NickLekas/436.5MHz-LNA/README.md

# 436.5MHz-LNA
A JFET common gate LNA for 436.5MHz

This is untested and may not work as designed.
