NickLekas/436.5MHz-LNA/LTSpice/LNA.asc

C1: cap; {Cdc}
C2: cap; {Cdc}
C3: cap; {Cdc}
C4: cap; {Cc}
C5: cap; {Cdc}
J1: njf; J310
L1: ind; {L1tune}
L2: ind; {L2tune}
L3: ind; {L3tune}
R1: res; {Rsource}
R2: res; {Rdrain}
R3: res; {Lloss}
R4: res; 100
R5: res; 50
R6: res; {Lloss}
R7: res; 50
R8: res; 10E6
R9: res; {Lloss}
V1: voltage; 9V
V2: voltage; ""; AC 2
V3: voltage; ""; AC 1
Named nets: 0, S11, S21
.param L2tune 39n
.param L3tune 39n
Output stage
.param Cc 1.2p
.param Lloss 2
.param Rsource 100
.ac lin 800 200Meg 800Meg
.model J310 NJF(Beta=3.384m Rd=1 Rs=1 Lambda=17m Vto=-3.409
+IS=193.9f Cgd=6.2p Pb=1 Fc=.5 Cgs=6.2p Kf=46.34E-18 Af=1)
.param L1tune 36n
input impedance ~180ohm
Use resonant inductor for L1 to tune S11
Input stage
Coupling L2 and L3 seems to make things worse
A coupling cap does improve performance, need to mess with coupling more
L2 tunes f0
L3 tunes gain
.param Rdrain 5
.param Cdc 10n
