NickLekas/436.5MHz-LNA/KiCad/436.5MHz LNA/436.5MHz LNA.kicad_pcb

## KiCad design KiCad/436.5MHz LNA/436.5MHz LNA.kicad_pcb (2022-03-18)

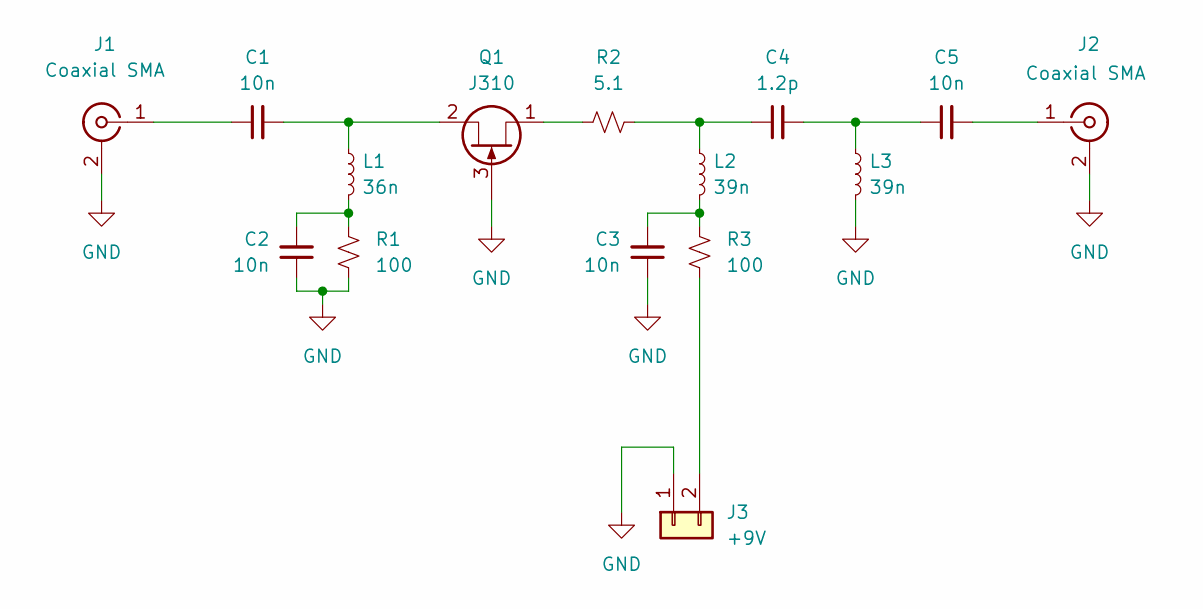
[picture p1: schematic 436.5MHz LNA.kicad_sch, 436.5MHz LNA]

Parts:
C1, C2, C3, C5: 10n; C_0603_1608Metric; MPN CL10C102JB8NNNC
C4: 1.2p; C_0603_1608Metric; MPN CC0603BRNPO9BN1R2‎
J1, J2: Coaxial SMA; SMA_Amphenol_132289_EdgeMount; MPN BU-1420701801
J3: +9V; PinHeader_1x02_P2.54mm_Vertical
L1: 36n; L_0603_1608Metric; MPN 0603DC-36NXJRW
L2, L3: 39n; L_0603_1608Metric; MPN 0603DC-39NXJRW
Q1: J310; SOT-23; MPN MMBFJ310LT3G
R1, R3: 100; R_0603_1608Metric; MPN CRGCQ0603F100R
R2: 5.1; R_0603_1608Metric; MPN RC0603FR-075R1L

Connections:
GND: C2.1, C3.1, J1.2 (Ext), J2.2 (Ext), J3.1, L3.2, Q1.3 (G), R1.2
unnamed: C1.1, J1.1 (In)
unnamed: C1.2, L1.1, Q1.2 (S)
unnamed: C2.2, L1.2, R1.1
unnamed: C3.2, L2.2, R3.1
unnamed: C4.1, L2.1, R2.2
unnamed: C4.2, C5.1, L3.1
unnamed: C5.2, J2.1 (In)
unnamed: J3.2, R3.2
unnamed: Q1.1 (D), R2.1

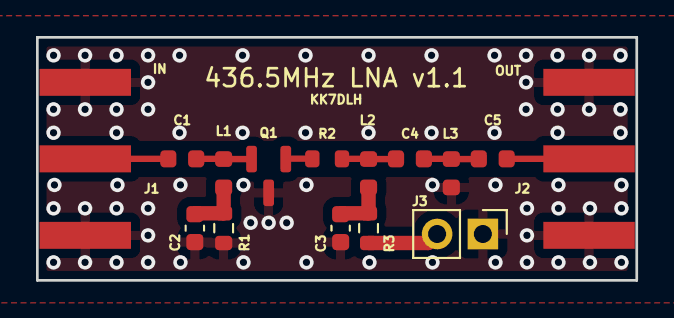
[picture p2: board 436.5MHz LNA.kicad_pcb from above]

Board: 2 copper layers, 33.3 x 13.5 mm, 15 parts (0 on the bottom side), 10 nets.
