NickLekas/436.5MHz-LNA/(commit log)

2022-03-08 generated OSH Park fab files
    [436.5MHz LNA-B_Cu.gbl, 436.5MHz LNA-B_Mask.gbs, 436.5MHz LNA-B_Silkscreen.gbo, 436.5MHz LNA-Edge_Cuts.gm1, 436.5MHz LNA-F_Cu.gtl, 436.5MHz LNA-F_Mask.gts, 436.5MHz LNA-F_Silkscreen.gto, 436.5MHz LNA.drl]
2022-03-08 added BOM
    [436.5MHz LNA.kicad_sch, 436.5MHz LNA_bom_1.0.csv]
2022-03-08 updated bom to purchase inductors from coilcraft and to remove most parts with terifs
    [436.5MHz LNA.kicad_sch, 436.5MHz LNA_bom_1.0.csv]
2022-03-18 no pushes from yesterday seem to have worked. Extended soldermask on rf path
    [436.5MHz LNA.kicad_pcb]
2022-03-18 flipped the JFET so the gate has a more common ground with the RF path
    [436.5MHz LNA.kicad_pcb, 436.5MHz LNA.kicad_sch]
